dholifield/split-keyboard/images/kb2.jpg

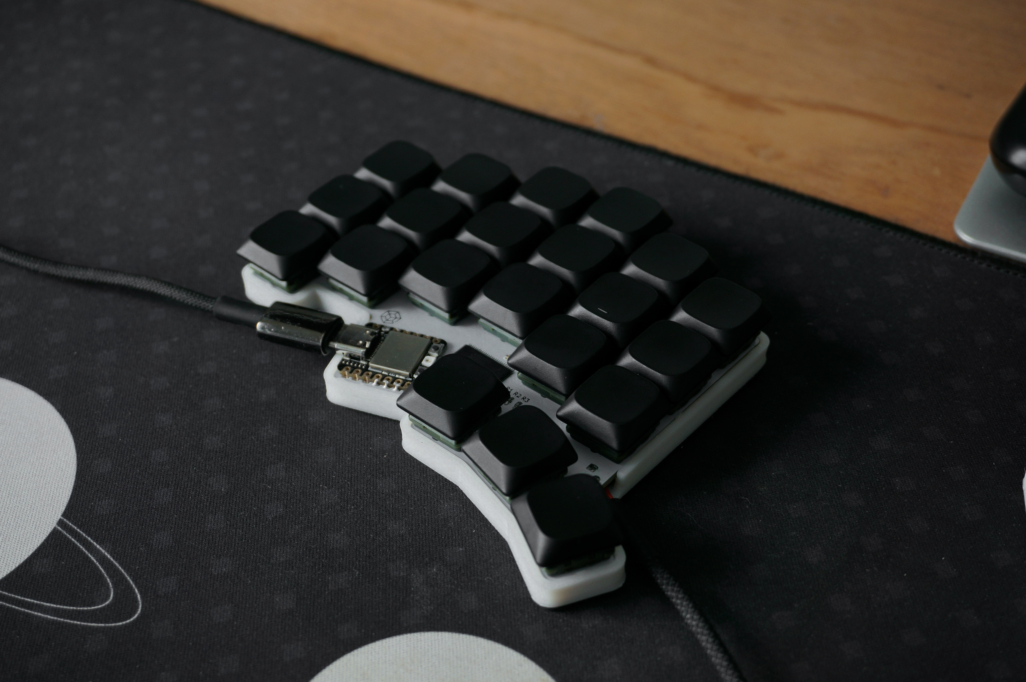
images/kb2.jpg
