dholifield/split-keyboard/pcb/split_keyboard_v3/split_keyboard_v3.csv

Reference | Qty | Value | DNP | Exclude from BOM | Exclude from Board | Footprint | Datasheet
C1,C2 | 2 | 0.1uF |  |  |  | Capacitor_SMD:C_0603_1608Metric_Pad1.08x0.95mm_HandSolder | ~
J1 | 1 | Vcc, SDA, SCL, INT, GND |  |  |  | Switches:SolderWire-5 | ~
JP1 | 1 | SolderJumper_3_Open |  | Excluded from BOM |  | Jumper:SolderJumper-3_P2.0mm_Open_TrianglePad1.0x1.5mm_NumberLabels | ~
PCA9505 | 1 | PCA9505DGG |  |  |  | Switches:PCA9505 | PCA9505DGG
R1,R2 | 2 | 1.6k |  |  |  | Resistor_SMD:R_0603_1608Metric_Pad0.98x0.95mm_HandSolder | ~
R3 | 1 | 2k |  |  |  | Resistor_SMD:R_0603_1608Metric_Pad0.98x0.95mm_HandSolder | ~
S0,S1,S2,S3,S4,S5,S6,S7,S8,S9,S10,S11,S12,S13,S14,S15,S16,S17,S18,S19,S20 | 21 | Keyswitch |  |  |  | Switches:Kailh_Low_Profile | ~
U1 | 1 | MCU_Seeed_XIAO_RP2040 |  |  |  | Switches:Seeed_XIAO_RP2040
