dholifield/split-keyboard/pcb/split_keyboard_v3/split_keyboard_v3.kicad_pcb

## KiCad design pcb/split_keyboard_v3/split_keyboard_v3.kicad_pcb (2025-06-14)

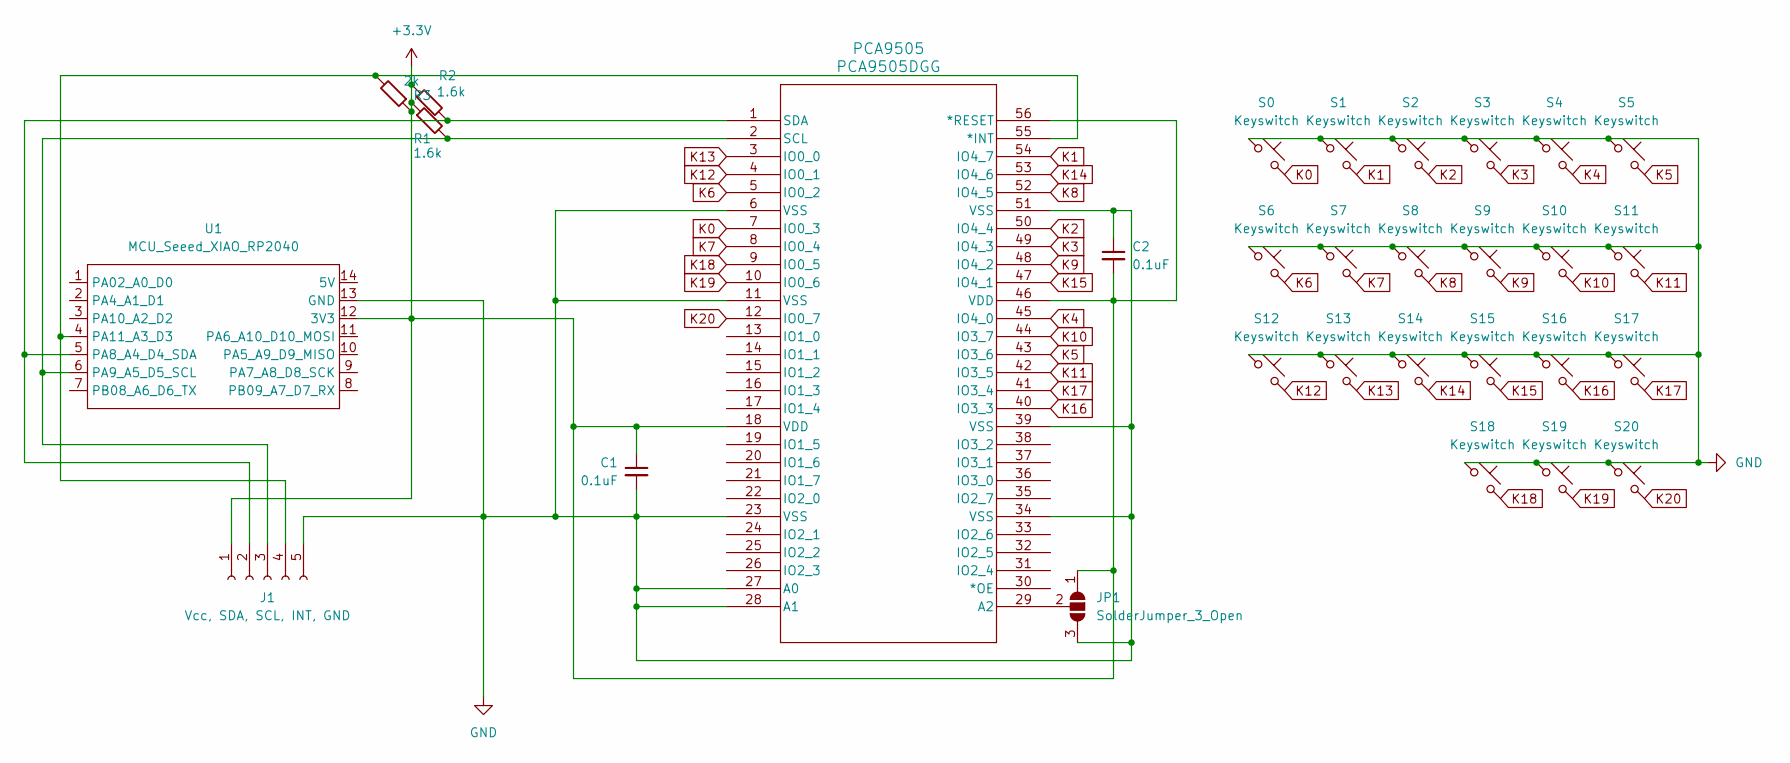
[picture p3: schematic split_keyboard_v3.kicad_sch]

Parts:
C1, C2: 0.1uF; C_0603_1608Metric_Pad1.08x0.95mm_HandSolder
J1: Vcc, SDA, SCL, INT, GND; SolderWire-5
JP1: SolderJumper_3_Open; SolderJumper-3_P2.0mm_Open_TrianglePad1.0x1.5mm_NumberLabels
PCA9505: PCA9505DGG; PCA9505
R1, R2: 1.6k; R_0603_1608Metric_Pad0.98x0.95mm_HandSolder
R3: 2k; R_0603_1608Metric_Pad0.98x0.95mm_HandSolder
S0, S1, S2, S3, S4, S5, S6, S7, S8, S9, S10, S11, S12, S13, S14, S15, S16, S17, S18, S19, S20: Keyswitch; Kailh_Low_Profile
U1: MCU_Seeed_XIAO_RP2040; Seeed_XIAO_RP2040

Connections:
+3.3V: C1.1, C2.2, J1.1, JP1.1 (A), PCA9505.18 (VDD), PCA9505.46 (VDD), PCA9505.56 (*RESET), R1.1, R2.1, R3.1, U1.12 (3V3)
GND: C1.2, C2.1, J1.5, JP1.3 (B), PCA9505.6 (VSS), PCA9505.11 (VSS), PCA9505.23 (VSS), PCA9505.27 (A0), PCA9505.28 (A1), PCA9505.34 (VSS), PCA9505.39 (VSS), PCA9505.51 (VSS), S0.1, S1.1, S2.1, S3.1, S4.1, S5.1, S6.1, S7.1, S8.1, S9.1, S10.1, S11.1, S12.1, S13.1, S14.1, S15.1, S16.1, S17.1, S18.1, S19.1, S20.1, U1.13 (GND)
K0: PCA9505.7 (IO0_3), S0.2
K1: PCA9505.54 (IO4_7), S1.2
K2: PCA9505.50 (IO4_4), S2.2
K3: PCA9505.49 (IO4_3), S3.2
K4: PCA9505.45 (IO4_0), S4.2
K5: PCA9505.43 (IO3_6), S5.2
K6: PCA9505.5 (IO0_2), S6.2
K7: PCA9505.8 (IO0_4), S7.2
K8: PCA9505.52 (IO4_5), S8.2
K9: PCA9505.48 (IO4_2), S9.2
K10: PCA9505.44 (IO3_7), S10.2
K11: PCA9505.42 (IO3_5), S11.2
K12: PCA9505.4 (IO0_1), S12.2
K13: PCA9505.3 (IO0_0), S13.2
K14: PCA9505.53 (IO4_6), S14.2
K15: PCA9505.47 (IO4_1), S15.2
K16: PCA9505.40 (IO3_3), S16.2
K17: PCA9505.41 (IO3_4), S17.2
K18: PCA9505.9 (IO0_5), S18.2
K19: PCA9505.10 (IO0_6), S19.2
K20: PCA9505.12 (IO0_7), S20.2
unnamed: J1.2, PCA9505.1 (SDA), R2.2, U1.5 (PA8_A4_D4_SDA)
unnamed: J1.3, PCA9505.2 (SCL), R1.2, U1.6 (PA9_A5_D5_SCL)
unnamed: J1.4, PCA9505.55 (*INT), R3.2, U1.4 (PA11_A3_D3)
unnamed: JP1.2 (C), PCA9505.29 (A2)

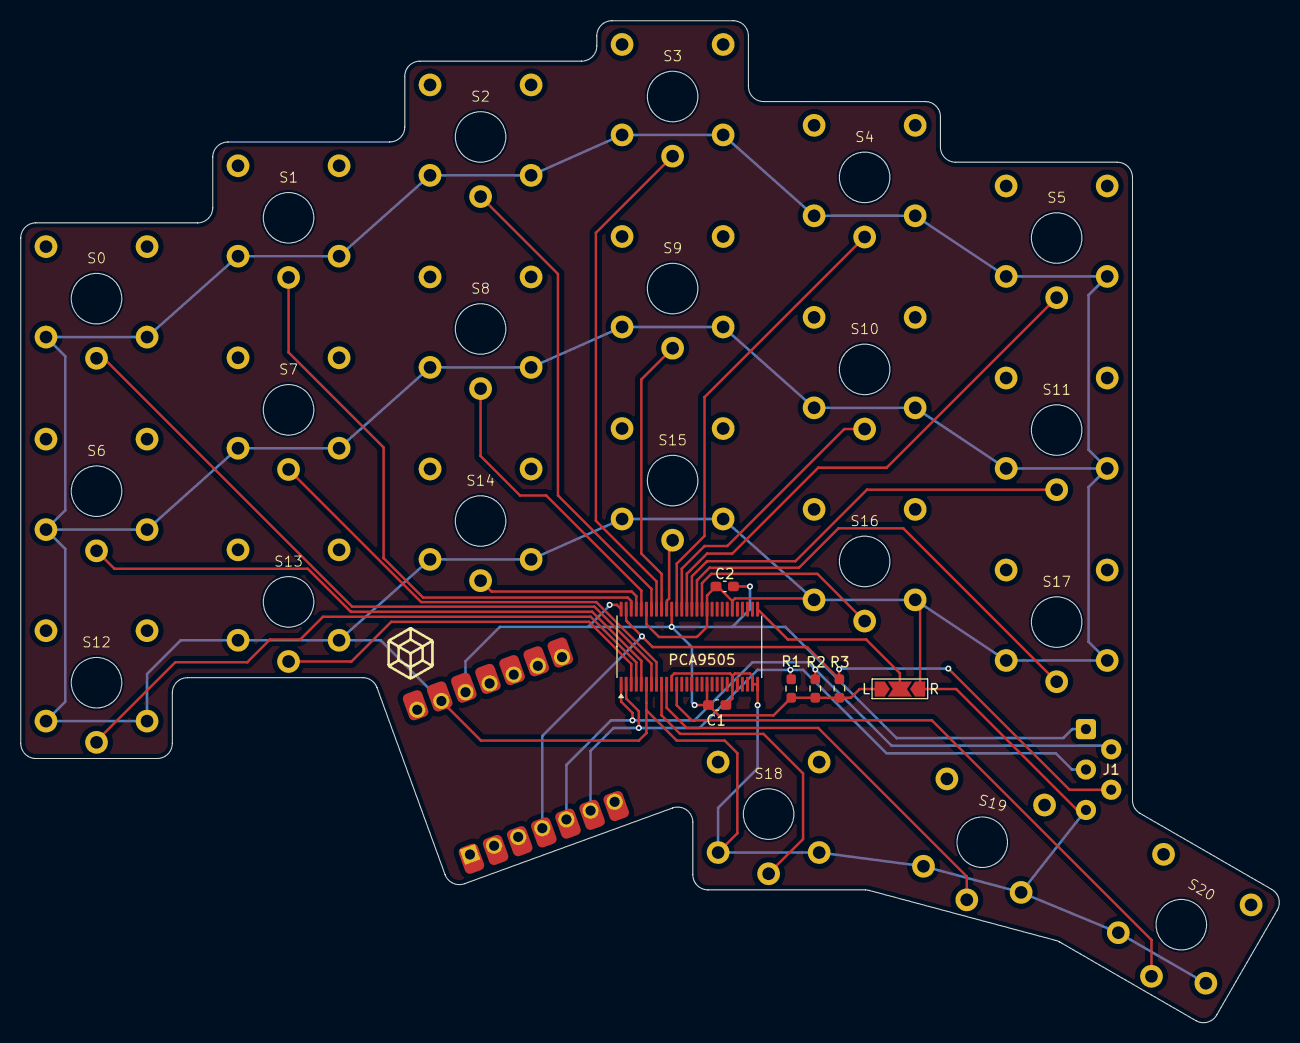
[picture p4: board split_keyboard_v3.kicad_pcb from above]

Board: 2 copper layers, 124.5 x 99.1 mm, 30 parts (0 on the bottom side), 27 nets.
