dholifield/split-keyboard/(commit log)

2025-06-14 add pcb
    [bom.csv, designators.csv, positions.csv, split_keyboard_v3.csv, split_keyboard_v3.kicad_pcb, split_keyboard_v3.kicad_sch]
2025-06-25 add arduino code
